rjiuzzol/QuP/README.md

# QuP
Quantum Power Project Multiplexer

Documentation for Quantum Power Multiplexer.
Developed in the scope of EMPIR project *19RPT01 QuantumPower - Quantum traceability for AC power standards*.

[http://quantumpower.cmi.cz](http://quantumpower.cmi.cz)

See also: [QPsw - Quantum Power software](https://github.com/KaeroDot/QPsw)
