rjiuzzol/QuP/Components/BOM_Arduino_Master_Display_Buttons_V01.xlsx

Id | Designator | Package | Quantity | Designation | Vendor | RS Stock No. | In a Pack of | DIGIKEY
1 | F1 | Fuse_Littelfuse-NANO2-451_453 | 1 | Fuse | Littelfuse Inc. - 015401.5DR |  |  | F1223CT-ND | 1.5A 125V AC 125V DC Fuse Board Mount (Cartridge Style Excluded) Holder, Surface Mount 2-SMD, Square End Block with Holder
2 | J5 | Molex_Mini-Fit_Jr_5566-04A_2x02_P4.20mm_Vertical | 1 | Conn_02x02_Top_Bottom | Molex - 39-28-1043 | 484-1899 | 10 | WM3801-ND | (MATING PART SEE NOTE 1) Molex, Mini-Fit Jr, 5566, 4 Way, 2 Row, Straight PCB Header
3 | D1 | D_SMB_Handsoldering | 1 | S2M | ON Semiconductor – S2M | 670-8845 | 10 |  | ON Semi 1000V 2A, Silicon Junction Diode, 2-Pin DO-214AA S2M
5 | J3 | PinSocket_2x03_P2.54mm_Vertical | 1 | Conn_02x03 | Sullins Connector Solutions – PPTC032LFBN-RC |  | 1 | S7071-ND | CONN HDR 6POS 0.1 TIN PCB
7 | J7 | PinSocket_1x06_P2.54mm_Vertical | 1 | Conn_PUSH_B | Würth Elektronik – 61300611121 |  | 1 | 732-5319-ND | CONN HEADER VERT 6POS 2.54MM
 | J7a option R/A | PinSocket_1x06_P2.54mm_Right Angle | 1 |  | Würth Elektronik – 61300611021 |  | 1 | 732-5339-ND | Connector Header Through Hole, Right Angle 6 position 0.100" (2.54mm)
8 | Trigger_IN1 | SMA_Amphenol_132134_Vertical | 1 | Conn_Coaxial | Amphenol RF – 132134 | 144-0905 | 1 |  | Amphenol RF 50Ω Straight PCB Mount SMA Connector, jack
9 | H4,H3,H2,H1 | MountingHole_3.2mm_M3 | 4 | MountingHole | ---- | ---- | -- | ----
10 | U3 | SOT-223-3_TabPin2 | 1 | LM1117-5.0 | Texas Instruments – LM1117MP-5.0/NOPB | 533-9583 | 1 |  | Texas Instruments LM1117MP-5.0/NOPB, LDO Regulator, 800mA, 5 V, ±1% 3+Tab-Pin, SOT-223
11 | U1 | SMDIP-8_W9.53mm | 1 | HCPL-2400 | Broadcom - HCPL-2400-300E | 450-834 | 1
15 | S1, S2, S3, S4, S5, S6 | IDC-Header_2x06_P2.54mm_Vertical | 6 | Conn_Slaves | MOLEX - 90130-1112 | 670-3275 | 5 | WM8236-ND | SEE MATING PART Connector Header Through Hole 12 position 0.100" (2.54mm)
16 | R1 | R_0805_2012Metric | 1 | 620 ohm | TE Connectivity – CPF0805B620RE | 666-2503 | 5
17 | C12,C9 | CP_Elec_5x3 | 2 | 10uF | Panasonic - EEEHB1V100R | 537-0865 | 5 |  | Panasonic 10μF Electrolytic Capacitor 35V dc, Surface Mount - EEEHB1V100R
18 | C1, C11 | C_0805_2012Metric | 2 | 100nF | KEMET – C0805C104K4RACTU | 648-0957 | 10
19 | C10 | CP_Elec_5x3 | 1 | 47uF | Panasonic – EEEFT1V470AR | 729-6261 | 10 |  | Panasonic 47μF Electrolytic Capacitor 35V dc, Surface Mount - EEEFT1V470AR
20 | C2 | C_0805_2012Metric | 1 | 15p | KEMET – C0805C150J5GACTU | 264-4242 | 25 |  | KEMET, 0805 (2012M) 15pF Multilayer Ceramic Capacitor MLCC 50V dc ±5% , SMD C0805C150J5GACTU
22 | J1 | PinSocket_2x21_P2.54mm_Vertical | 1 | Conn_02x21=42 in two parts |  |  |  |  | SEE NOTE 01
 | J1A |  |  | conn 16pos 2 rows | Sullins Connector Solutions – PPTC082LFBN-RC |  | 1 | S7076-ND | CONN HDR 16POS 0.1 TIN PCB
 | J1B |  |  | conn 32pos 2 rows | Sullins Connector Solutions - PPTC162LFBN-RC |  | 1 | S7084-ND | CONN HDR 32POS 0.1 TIN PCB
23 | J2 | PinSocket_2x16_P2.54mm_Vertical | 1 | Conn_02x16 | Sullins Connector Solutions – PPTC162LFBN-RC |  | 1 | S7084-ND | CONN HDR 32POS 0.1 TIN PCB
24 | J4 | PinHeader_1x04_P2.54mm_Vertical | 1 | Conn_DISPLAY_I2C | Würth Elektronik – 61300411121 |  | 1 | 732-5317-ND | CONN HEADER VERT 4POS 2.54MM
 | J4 Option R/A | PinHeader_1x04_P2.54mm_Right Angle | 1 |  | Würth Elektronik – 61300411021 |  | 1 | 732-5337-ND | Connector Header Through Hole, Right Angle 4 position 0.100" (2.54mm)
 | uController |  |  |  |  | VENDOR ID
 | uC1 | uController | 1 | ATmega2560-Embed | www.robotdyn.com | SKU#:6970622932482 |  |  | https://robotdyn.com/mega-2560-pro-embed-ch340g-atmega2560-16au-with-pinheaders.html
 | Display | In the list there are two suppliers for the same Display
 | Suplier #1
 | LCD | LCD Display 20x04 | 1 | LCD2004 – HD44780 | https://www.adafruit.com/product/198 | PRODUCT ID: 198 |  |  | Standard LCD 20x4 + extras - white on blue
 |  | I2C to Parallel dispplay HD44780 adapter | 1 | I2C Display PCF8574 | https://www.adafruit.com/product/292 | PRODUCT ID: 292 |  |  | i2c / SPI character LCD backpack
 | Suplier #2
 |  | HD44780 2004 display LCD 4x20 sign Blue |  |  | https://www.az-delivery.de/en/products/copy-of-hd44780-2004-lcd-display-bundle-4x20-zeichen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
 |  | I2C IIC adapter serial interface for LCD display 1602 and 2004 |  |  | https://www.az-delivery.de/en/products/serielle-schnittstelle?_pos=4&_sid=04c12cf1b&_ss=r
 | PUSH Buttons
1 | SW4 | SW_PUSH-12mm | 1 | SW_uC_RST | E-Switch – TL1100F160Q6JBLK – Square |  | 1 | EG5991-ND | Tactile Switch SPST-NO Top Actuated Through Hole
2 | SW3 | SW_PUSH-12mm | 1 | SW_LOC_REM | E-Switch – TL1100F160Q6JBLK – Square |  | 1 | EG5991-ND | Tactile Switch SPST-NO Top Actuated Through Hole
3 | SW2 | SW_PUSH-12mm | 1 | SW_CH_ENA | E-Switch – TL1100F160Q6JBLK – Square |  | 1 | EG5991-ND | Tactile Switch SPST-NO Top Actuated Through Hole
4 | SW1 | SW_PUSH-12mm | 1 | SW_MUX_RST | E-Switch – TL1100F160Q6JBLK – Square |  | 1 | EG5991-ND | Tactile Switch SPST-NO Top Actuated Through Hole
5 | H5,H4,H3,H2,H1 | MountingHole_2.2mm_M2 | 5 | Board Standoff | Würth Elektronik – 971150244 |  |  | 732-12936-ND | Hex Standoff Threaded M2 Brass 0.591" (15.00mm) Silver
6 | R4 | R_1206_3216Metric | 1 | 10k | Panasonic – ERJP08F1002V | 721-9908 | 5 |  | Panasonic 10kΩ, 1206 (3216M) Thick Film SMD Resistor ±1% 0.66W - ERJP08F1002V
7 | R3,R2,R1 | R_0805_2012Metric | 3 | 1k | Panasonic – ERJP06F1001V | 721-7741 | 5 |  | Panasonic 1kΩ, 0805 (2012M) Thick Film SMD Resistor ±1% 0.5W - ERJP06F1001V
8 | J1 | PinHeader_1x06_P2.54mm_Horizontal | 1 | Conn_01x06 | Sullins Connector Solutions -PEC06SBAN |  | 1 | S1112E-06-ND | Connector Header Through Hole, Right Angle 6 position 0.100" (2.54mm)
9 | D1 | D_SOD-123 | 1 | 1N4148 or Similar | Vishay Semiconductor Diodes Division – 1N4148W-HE3-08 |  | 1 | 1N4148W-HE3-08GICT-ND
10 | C4 | C_0805_2012Metric | 1 | 22pF | KEMET - C0805C220J5GACTU | 264-4258 | 25 |  | KEMET, 0805 (2012M) 22pF Multilayer Ceramic Capacitor MLCC 50V dc ±5% , SMD C0805C220J5GACTU
11 | C3,C2,C1 | C_0805_2012Metric | 3 | 47nF | KEMET – C0805C473K5RACTU | 264-4393 | 25 |  | KEMET, 0805 (2012M) 47nF Multilayer Ceramic Capacitor MLCC 50V dc ±10% , SMD C0805C473K5RACTU
 | For round push buttons use this one as SW1 to SW4
 |  | SWITCH TACTILE SPST-NO 0.05A 12V |  |  | E-Switch – TL1265AQSBLK – Round |  |  | EG4968-ND | Tactile Switch SPST-NO Top Actuated Through Hole – ROUND
 | NOTE 1
 | MATING PARTS
 | POWER SUPPLY CON
1a | 1 | MOLEX – 0039012045 |  |  |  |  |  | WM23701-ND | 4 Rectangular Connectors - Housings Receptacle Natural 0.165" (4.20mm)
1b | 4 | MOLEX – PIN – 0039000039 |  |  |  |  |  | WM2501-ND | CONN SOCKET 18-24AWG CRIMP TIN
 | PMOD Connector Master-to-Slave
1 | S1, S2, S3, S4, S5, S6 | Pin Housing | 12 |  | Molex – 0901420012 | --- | --- | WM8038-ND | 12 Rectangular Connectors - Housings Receptacle Black 0.100" (2.54mm)
2 |  | Pin TIN | 144 |  | Molex – 0901192120 |  |  | WM2560-ND | CONN SOCKET 26-28AWG CRIMP TIN
3 | Option A | CBL RIBN 12COND 0.100 GRAY 100' | 1 |  | 3M - 8124/12 100 or similar | --- | 3 m | 3M156819-10-ND | Flat Ribbon Cable Gray 12 Conductors 0.100" (2.54mm) Flat Cable 10.0' (3.05m)
 | Option B | CBL RIBN 12COND 0.100 GRAY 1' | 6 |  | 3M - 8124/12 100 |  | 30 cm | 3M156819-1-ND | Flat Ribbon Cable Gray 12 Conductors 0.100" (2.54mm) Flat Cable 1.00' (304.80mm)
 |  | NOTE: the required quantity of the ribbon cable is for 6 slave boards. If option A is chosen the cable has to be cut into pieces according to MASTER-SLAVE distances. Option B are individual cables of 30 cm each. There are more length options at Digikey
 | USB cable
1 |  | USB panel to micro usb | 1 |  | Adafruit Industries LLC – 3258 | --- | --- | 1528-1786-ND | PANEL MOUNT EXTENSION USB CABLE
 | Master to Display cable
1 |  | CONN RCPT HSG 4POS 2.54MM | 2 |  | Harwin Inc. - M20-1060400 |  |  | 952-2229-ND | 4 Rectangular Connectors - Housings Receptacle Black 0.100" (2.54mm)
2 |  | CONN SOCKET 22-30AWG CRIMP TIN | 8 |  | Harwin Inc. - M20-1180046 |  |  | 952-2159-ND | Socket Contact Tin 22-30 AWG Crimp
3 |  | CBL RIBN 4COND 0.100 GRAY 1' | 1 |  | 3M - 8124/04 100 |  | 304.80mm length | 3M156816-1-ND | Flat Ribbon Cable Gray 4 Conductors 0.100" (2.54mm) Flat Cable 1.00' (304.80mm)
 | Master to Push_Buttons cable
1 |  | CONN RCPT HSG 6POS 2.54MM | 2 |  | Harwin Inc. - M20-1060600 |  |  | 952-2231-ND | 6 Rectangular Connectors - Housings Receptacle Black 0.100" (2.54mm)
2 |  | CONN SOCKET 22-30AWG CRIMP TIN | 12 |  | Harwin Inc. - M20-1180046 |  |  | 952-2159-ND | Socket Contact Tin 22-30 AWG Crimp
3 |  | CBL RIBN 6COND 0.100 GRAY 1' | 1 |  | 3M - 8124/06 100 |  | 304.80mm length | 3M155851-1-ND | Flat Ribbon Cable Gray 6 Conductors 0.100" (2.54mm) Flat Cable 1.00' (304.80mm)
