rjiuzzol/QuP/Components/BOM_Multiplexer_Opto_V01_2Layer.xlsx

Id | Designator | Package | Quantity | Designation | Vendor | RS Stock No. | In a Pack of
1 | R27,R36,R35,R34,R33,R32,R31,R30,R29,R25,R22,R21,R18,R17,R14,R13,R10,R9,R6,R5,R2,R1 | R_0805_2012Metric | 22 | 20 | Panasonic – ERJP06F20R0V | 721-7615 | 5
2 | R28,R26,R24,R23,R20,R19,R16,R15,R12,R11,R8,R7,R4,R3 | R_0805_2012Metric | 14 | 390 | Panasonic – ERJP06F3900V | 721-7719 | 5
3 | C14,C12,C13,C11,C10,C9,C8,C7,C6,C5,C4,C3,C2,C1 | C_1206_3216Metric | 14 | 1uF | KEMET – C1206C105K4RACTU | 648-0733 | 10
5 | U17,U2,U1 | SOIC-20W_7.5x12.8mm_P1.27mm | 3 | 74LS244ADW | TI – SN74LS244DW | 121-8344 | 25 | SEE NOTE 1 | Or Similar HC, LVC 5 V compatible
6 | C26,C24,C23 | C_0805_2012Metric | 3 | 100nF | KEMET – C0805C104K4RACTU | 648-0957 | 10
7 | C22,C21,C20,C19,C18,C17,C16,C15 | C_0805_2012Metric | 8 | 1uF | KEMET – C0805C105J3RACTU | 146-4275 | 10
9 | C25 | CP_Elec_5x3 | 1 | 22uF | Panasonic – EEEHB1C220R | 537-0758 | 5
13 | U16,U15,U14,U13,U12,U11,U10,U9,U8,U7,U6,U5,U4,U3 | SMD-6_W7.62mm_SMDSocket_SmallPads | 14 | VO14642AABTR | VISHAY – VO14642AABTR | 180-7112 | 5 | SEE NOTE 2 | Vishay, VO14642AABTR MOSFET Output Optocoupler, Surface Mount, 6-Pin SMD
17 | J8 | IDC-Header_2x06_P2.54mm_Vertical | 1 | Conn_02x06_Top_Bottom | MOLEX - 90130-1112 | 670-3275 | 5
18 | J3 | SMA_Amphenol_132136_Vertical | 1 | Conn_CH2 | Amphenol RF – 132136 | 194-3193 | 1 | SEE NOTE 3 | Amphenol RF 50Ω Right Angle Through Hole SMA Connector, jack
19 | J2 | SMA_Amphenol_132136_Vertical | 1 | Conn_CH1 | Amphenol RF – 132136 | 194-3193 | 1 |  | Amphenol RF 50Ω Right Angle Through Hole SMA Connector, jack
20 | J1 | SMA_Amphenol_132136_Vertical | 1 | Com_IO | Amphenol RF – 132136 | 194-3193 | 1 |  | Amphenol RF 50Ω Right Angle Through Hole SMA Connector, jack
10 | J11 | Pin_D1.0mm_L10.0mm | 1 | GRDo_1 | Amphenol ICC - 68000-401HLF | 863-2706 | 100 | SEE NOTE 4 | Amphenol FCI, BergStik, 1 Way, 1 Row, Straight Pin Header
12 | J10,J9,J7 | Pin_D1.0mm_L10.0mm | 3 | MEAS_GND
14 | J6 | Pin_D1.0mm_L10.0mm | 1 | GRDo_2
15 | J5 | Pin_D1.0mm_L10.0mm | 1 | GRDi_2
16 | J4 | Pin_D1.0mm_L10.0mm | 1 | GRDi_1
21 | MK3,MK1,MK4,MK2 | MountingHole_2.7mm | 4 | Mounting_Hole_PAD | NA
4 | TP6,TP2,TP5,TP4,TP3,TP1 | TestPoint_Pad_D1.0mm | 6 | TestPoint | NA
8 | TP7 | TestPoint_Pad_D1.0mm | 1 | VCC | NA
11 | TP0 | TestPoint_Pad_D1.0mm | 1 | GNDDigital | NA
 | NOTES
 | NOTE 1
 | The designation on the schematic correspond to the 3V3 version. Have to be ignored. The micro-controller is 5 V TTL digital level
 | NOTE 2
 | The designation on the schematic correspond to the DIP Package version. Have to be ignored The SMD package is the right designation
 | NOTE 3
 | If the straight SMA connector is prefered used the following specification
18 | J3 | SMA_Amphenol_132134_Vertical | 1 | Conn_CH2 | Amphenol RF – 132134 | 144-0905 | 1 |  | Amphenol RF 50Ω Straight PCB Mount SMA Connector, jack
19 | J2 | SMA_Amphenol_132134_Vertical | 1 | Conn_CH1 | Amphenol RF – 132134 | 144-0905 | 1 |  | Amphenol RF 50Ω Straight PCB Mount SMA Connector, jack
20 | J1 | SMA_Amphenol_132134_Vertical | 1 | Com_IO | Amphenol RF – 132134 | 144-0905 | 1 |  | Amphenol RF 50Ω Straight PCB Mount SMA Connector, jack
 | NOTE 4
 | It is suggested for Ground and Guard solder a D1mm cable directly to the PCB in order to avoid bad contact.
