rjiuzzol/QuP/Components/Enclosure_Connectors_V01-01.xlsx

Front Panel connectors
Id | Designator | Package | Quantity | Designation | Vendor | RS Stock No. | In a Pack of | DIGIKEY
1 | BNC-to-SMA | BNC Panel to SMA | 19 |  | Amphenol RF – 095-850-246M050 |  |  | 115-095-850-246M050-ND | Cable Assembly Coaxial BNC to SMA Female to Male RG-58 19.69" (500.00mm)
 | NOTE: 3 Connectors per slave. 1 connector for external trigger
 | OPTION B. Coax cable assembly kit | BNC + COAX cable + SMA
1a | BNC red – output | BNC panel mount | 6 |  | STAUBLI (MC) – 67.9764-22 | 225-5347 |  |  | Staubli Straight Panel Mount BNC ConnectorBulkhead Fitting, jack
1b | BNC black – input + Trigger | BNC panel mount | 13 |  | STAUBLI (MC) – 67.9764-21 | 225-5331 |  |  | Staubli Straight Panel Mount BNC ConnectorBulkhead Fitting, jack
1c | SMA Cable Crimp | SMA cable | 19 |  | Amphenol RF – 132114 | 144-0931 |  |  | Amphenol RF 50Ω Straight Cable Mount SMA Connector, Plug, LMR100, M17/119-RG174, RG174, RG188, RG188A, RG316
1d | COAX cable | RG174 | 1 |  | RS PRO (20 m) | 222-8610 | 1 reel of 20 m |  | RS PRO Black Unterminated to Unterminated RG174A/U Coaxial Cable, 50 Ω 2.79mm OD 20m
 | NOTE: The coax cable is sold in reel of 20 m
 | NOTE: The BNC color is as a guide, black input, red output
2 | Slave GND -Binding Post | binding post GREEN | 7 | GND | Pomona Electronics – 3750-5 |  |  | 501-1787-ND | Binding Post Connector Standard Knurled Green Gold
3 | Channel Guard -Binding Post | binding post BLUE | 18 | GRD | Pomona Electronics – 3750-6 |  |  | 501-2399-ND | Binding Post Connector Standard Knurled Blue Gold
 | NOTE: 3 Connectors per slave
4a | Power connector | Panel mount | 1 | PWR | ITT Cannon, LLC – APD-1CPH8-2 |  |  | 1003-2071-ND | 2 (Power) Position Circular Connector Receptacle Housing Panel Mount
4b | Contact pins for 4a |  | 2 | PWR-PIN | ITT Cannon, LLC – 430-8645-000 |  |  | 1003-2176-ND | CONTACT PIN CRIMP SILVER
4c | Cable connector miting part for 4a | Cable conn | 1 | PWR | ITT Cannon, LLC – APD-1BSH8-2 |  |  | 1003-2069-ND | 2 (Power) Position Circular Connector Plug Housing Free Hanging (In-Line) Coupling Nut
4d | Contact pins for 4c | Cable pin | 2 | PWR-PIN | ITT Cannon, LLC – 031-8646-011 |  |  | 1003-2023-ND | CONTACT SOCKET CRIMP SILVER
5 | LCD spacer | aluminium | 4 | spacer | Würth Elektronik – 970100366 |  |  | 732-12798-ND | Hex Spacer Threaded M3 Aluminum 0.394" (10.00mm)
6 | Push Button spacer | brass | 5 | spacer | Würth Elektronik – 970120244 |  |  | 732-12852-ND | Hex Spacer Threaded M2 Brass 0.472" (12.00mm) Silver
