rjiuzzol/QuP/Components/Enclosure_Connectors_V01-03.xlsx

Sheet: Enclosure
Front Panel connectors
Id | Designator | Package | Quantity | Designation | Vendor | RS Stock No. | In a Pack of | DIGIKEY
1 | BNC-to-SMA | BNC Panel to SMA | 19 |  | Amphenol RF – 095-850-246M050 |  |  | 115-095-850-246M050-ND | Cable Assembly Coaxial BNC to SMA Female to Male RG-58 19.69" (500.00mm)
 | NOTE: 3 Connectors per slave. 1 connector for external trigger
 | OPTION B. Coax cable assembly kit (DIY) | BNC + COAX cable + SMA
1a | BNC red – output | BNC panel mount | 6 |  | STAUBLI (MC) – 67.9764-22 | 225-5347 |  |  | Staubli Straight Panel Mount BNC ConnectorBulkhead Fitting, jack
1b | BNC black – input + Trigger | BNC panel mount | 13 |  | STAUBLI (MC) – 67.9764-21 | 225-5331 |  |  | Staubli Straight Panel Mount BNC ConnectorBulkhead Fitting, jack
1c | SMA Cable Crimp | SMA cable | 19 |  | Amphenol RF – 132114 | 144-0931 |  |  | Amphenol RF 50Ω Straight Cable Mount SMA Connector, Plug, LMR100, M17/119-RG174, RG174, RG188, RG188A, RG316
1d | COAX cable | RG174 | 1 |  | RS PRO (20 m) | 222-8610 | 1 reel of 20 m |  | RS PRO Black Unterminated to Unterminated RG174A/U Coaxial Cable, 50 Ω 2.79mm OD 20m
 | NOTE: The coax cable is sold in reel of 20 m
 | NOTE: The BNC color is as a guide, black input, red output
2 | Slave GND -Binding Post | binding post GREEN | 1 | GND | Pomona Electronics – 3750-5 |  |  | 501-1787-ND | Binding Post Connector Standard Knurled Green Gold
 | NOTE: ONLY one Measurment GND connector
3 | Channel Guard -Binding Post | binding post BLUE | 18 | GRD | Pomona Electronics – 3750-6 |  |  | 501-2399-ND | Binding Post Connector Standard Knurled Blue Gold
 | NOTE: 3 Connectors per slave
4a | DC jack | Panel mount | 1 |  | Switchcraft - L712AS | 705-1525 |  | SC1390-ND | Conector hembra DC, Montaje en Panel Recto, 30,0 V., 5.0A, IP68
4b | DC plug | Wire | 1 |  | Switchcraft -761KS15 | 705-1519 |  | SC1382-ND | Conector macho DC, Diámetro Int. 2.5mm, Diámetro Ext. 5.5mm, Montaje de Cable Recto, 5.0A, IP68
5 | LCD spacer | aluminium | 4 | spacer | Würth Elektronik – 970100366 |  |  | 732-12798-ND | Hex Spacer Threaded M3 Aluminum 0.394" (10.00mm)
6 | Push Button spacer | brass | 5 | spacer | Würth Elektronik – 970120244 |  |  | 732-12852-ND | Hex Spacer Threaded M2 Brass 0.472" (12.00mm) Silver
7 | Any External Power supply AC/DC | DC output | 9 V | 20 W to 30 W

Sheet: 3U Enclosures
3 U 19’’ chasis
Option 1)
Scroff at Digikey
https://www.digikey.com/en/products/detail/schroff/14575175/4209746
Option 2)
RS components
https://int.rsdelivers.com/product/rs-pro/pf-19-3u-d2/rs-pro-3u-rack-mount-case-ventilated/6657716
RS PRO, 3U Rack Mount Case Ventilated
RS Stock No. |  | 665-7716
Brand | RS PRO
Option 3)
https://schroff.nvent.com/sites/g/files/hdkjer281/files/acquiadam/2021-05/6_1_schroff_cat_europacpro_en.pdf
Minimun recommended size
Height | 3 U
Width | 19’’ | rack
Depth | 235 mm
Boards size
Master | 160 mm x 100 mm
Slave 2-to-1 | 160 mm x 100 mm
Slave 4-to-1 | 225 mm x 100 mm
