rjiuzzol/QuP/(commit log)

2023-03-10 Update wlsfit.m
    The Vandermonde matrix has to be in decreasing order of power.
2023-04-14 new version 2.2
    Sequence start fixed
    [Mux.cpp, Mux.h, MuxDefs.h, QuP_Multiplexer_V02.2.ino, Sequence.cpp, Sequence.h, Slave.cpp, Slave.h]
2023-04-14 New version 2.2
    Sequence variables fixed
    [Mux.cpp, Mux.h, MuxDefs.h, QuP_Multiplexer_V022_INRIM.ino, Sequence.cpp, Sequence.h, Slave.cpp, Slave.h]
